frankyhub/Roby_Eyes/README.md

<div align="center">

|[:skull:ISSUE](https://github.com/frankyhub/Roby_Eyes/issues?q=is%3Aissue)|[:speech_balloon: Forum /Discussion](https://github.com/frankyhub/Roby_Eyes/discussions)|[:grey_question:WiKi](https://github.com/frankyhub/Roby_Eyes/wiki)||
|--|--|--|--|
| | | | |
<a href="https://github.com/frankyhub/Roby_Eyes/issues">|<a href="https://github.com/frankyhub/Roby_Eyes/discussions">|<a href="https://github.com/frankyhub/Roby_Eyes/6eleases">||
|| <a href="https://github.com/frankyhub/Roby_Eyes/pulse" alt="Activity">| <a href="https://github.com/frankyhub/Roby_Eyes/graphs/traffic">  |<a href="https://github.com/frankyhub?tab=stars"> ||

# Roby_Eyes

 
<br> <br>

## Story:
Das Repo beschreibt den Roby_Eyes, er hat zwei MAX7219 Displays für die Augen und er kann laufen, tanzen und den Moonwalk. Jedes Bein hat zwei Gelenke, die von Servo-Motoren bewegt werden. Als Steuerung dient ein Arduino NANO, gespeist von einer 9V-Batterie.
Die Roby_Eyes-Elemente werden aus einer 3mm Sperrholzplatte gelasert.

## Die Stückliste:

| Anzahl | Bezeichnung | 
| --- | --- |
| 1  | Sperrholzplatte 300x600x3mm  | 
|  1 | NANO-Shield  | 
| 1  | Arduino NANO V3  | 
| 1  |  40 Pin Male 2,54mm Stiftleisten einreihig für das NANO-Shield | 
|  1 |  40 Pin Female 2,54 mm Buchsenleiste einreihig für das NANO-Shield | 
| 1  | Schalter 1 polig  | 
| 2  | MAX7219 Displays  | 
| 1  | 9V Batterie  | 
| 1  | 9V Batterie-Klipp  | 
| 4  | Servo Motore SG90  | 
| 2  | Zylinderkopf Schrauben M3x8  | 
| 1  | Kabelbinder 10cm  | 
| 1  | Holzleim  | 
| 1  | Sekundenkleber  | 
| 1  | 20cm Schaltlitze 0,25mm2  | 

## Der NANO mit Shield und Stiftleisten

 
<br> <br>

## Aufbau und Montage

Der Aufbau und die Montage von Robi ist in mehrere Schritte unterteilt

## Schritt 1: 

Verwende die Lasercutter Vorlage, bestehend aus, Kopfteil, Füße und Schuhe

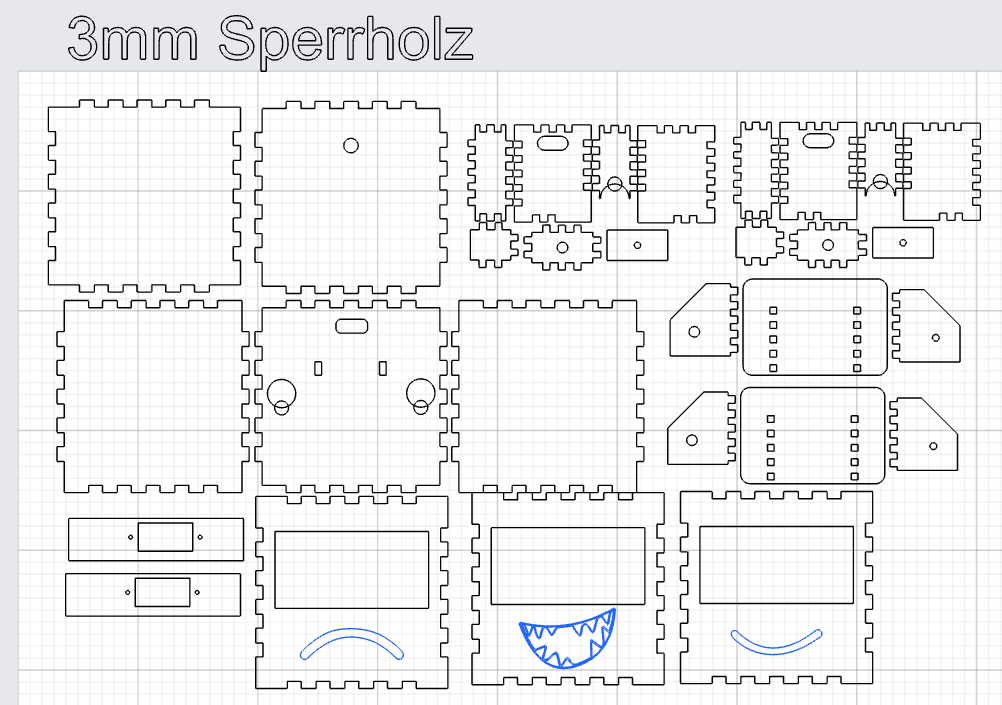
[picture p1: pic/07robi.png]
 
<br> <br>

## Schritt 2: 

Das Kopfteil montieren. Die Deckplatte noch nicht verkleben.

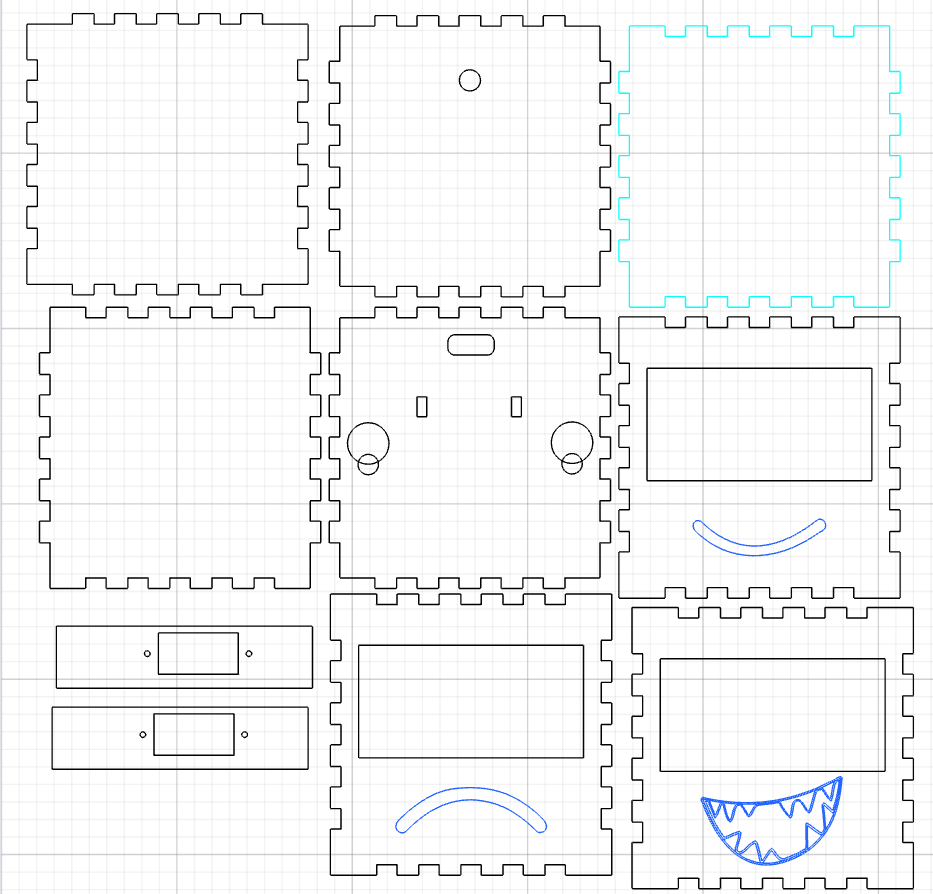
[picture p2: pic/08robi.png]
 
<br> <br>

## Schritt 3: 

Die Hülle der beiden Füße verkleben.
Achtung: Wir benötigen zwei Füße. Die Öffnungen für die Servokabel sind jeweils innen und die Servos zeigen nach vorne!

 
<br> <br>

 
<br> <br>

 
<br> <br>

Die beiden Oberteile der Füße deckungsgleich verkleben (noch nicht an die Füße kleben!).

 
<br> <br>

Die Oberteile der Füße werden an den Servo im Kopfteil geschraubt.

Alternativ können zu besseren Stabilität auch die 3D-Druck Teile verwendet werden.

 
<br> <br>

## Schritt 4: 
Den Robi verdrahten, die Bauteile jedoch noch nicht in das Gehäuse montieren.

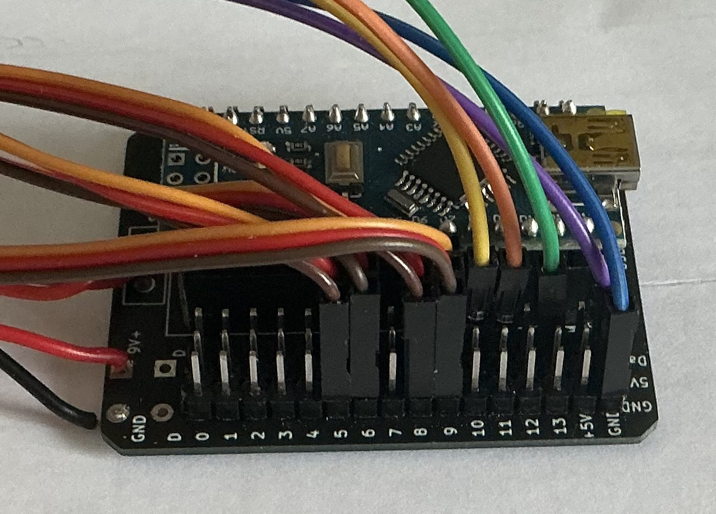
[picture p3: pic/NANO.png]
 
<br> <br>

|	Servo	|	NANO|
| --- | --- |
| Servo rechts oben| D5|
| Servo rechts unten | D6 |
| Servo links oben | D8 |
| Servo links unten  |D9 |
| -------- | -------- | 

 
<br> <br>

<br> <br>

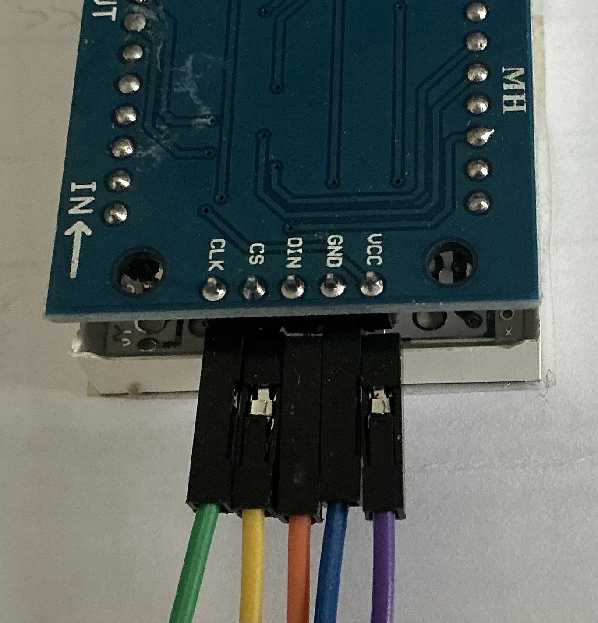
[picture p4: pic/MAX.png]
 
<br> <br>

  |  MAX72xx | NANO |
| -------- | -------- | 
|    VCC | 5V|
|    GND| GND|
 |   DIN | D11|
|    CS |  D10|
|    CLK | D13|
| -------- | -------- | 

## Schritt 5: 
Wir starten den ersten Funktionstest. Den NANO mit der Arduino IDE (Robi_tanzt.ino) programmieren. Es stehen auch Testprogramme für die Servos und das LED-Display zur Verfügung.

Im Robi_tanzt.ino Programm kann zur korrekten Position der Servos der CALIBRATION-Modus gewählt werden (Programmzeile 233).

Ist der Robi programmiert und sind die Servos in 90° Stellung, können sie in das Kopfteil und in die Füße montiert werden.

## Schritt 6: 
Die beiden Servos in 90° Stellung mit den unteren Kopfteil und den Oberteil der Füße verschrauben. Die Servos sollten durch die Verschraubung fest am Kopfteil sitzen. Anschließend die 9V-Batterie mit den Kabelbinder befestigen.

 
<br> <br>

Die Schrittmotore in die Fußhülle montieren und das Fuß Unterteil ankleben

 
<br> <br>

Die Schuhe an die Füße montieren

 
<br> <br>

Die Servo-Kabel in den Body führen und die Füße an die Fußoberteile kleben

 
<br> <br>

Alternativ können zu besseren Stabilität auch die 3D-Druck Teile verwendet werden.

 
<br> <br>

## Schritt 7: 

Das "RUN" Programm in den NANO laden.

Es stehen 3 Programm-Modis zur Verfügung.

In der Programmzeile 233 den "RUN" Modus auswählen:

+ //#define INSTALL
+ //#define CALIBRATION
+ #define RUN

Ist der erste Funktionstest erfolgreich, kleben wir die 3D Druck Abstandshalter auf das NANO-Shield und kleben den NANO 
mit Shield, das LED-Display in das Kopfteil und montieren den Schalter in die Kopfteil Platte. Das Kopfteil jetzt 
vollständig zusammenbauen.

</div>

<div align="center">
  
## Schritt 8

Es stehen auch 3D-Druck Arme zur Verfügung, die an das Kopfteil geklebt werden. 

Jetzt kann Roby tanzen.

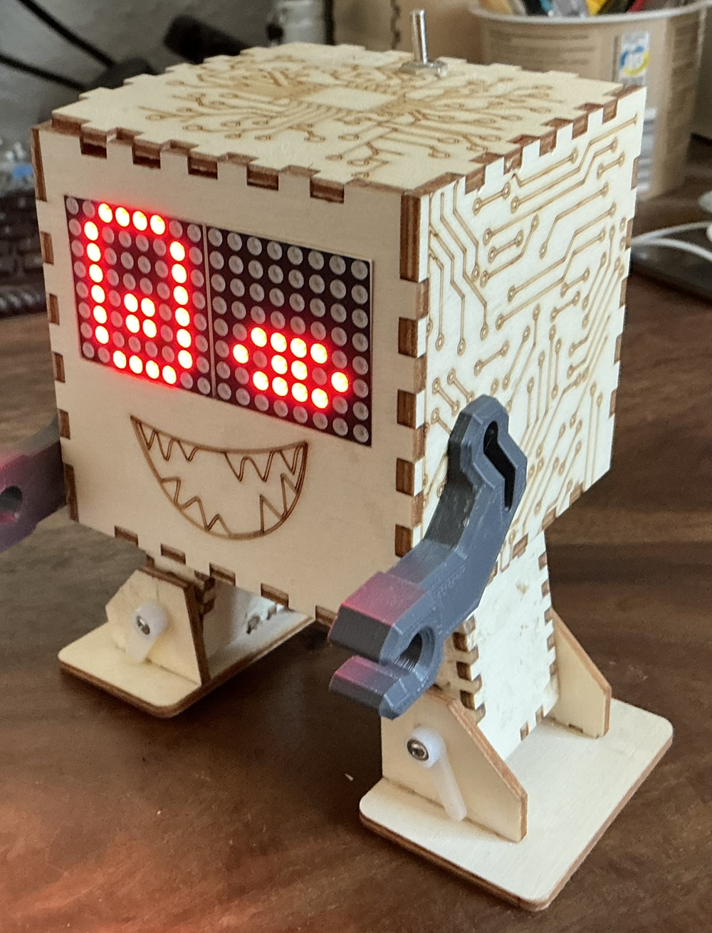
[picture p5: pic/RobiEyes.png]
 
<br> <br>
  
---

## Servo-Motor Impulsdiagramme:

 
<br> <br>

Impulsdiagramm: Ansteuerung des Servos mit einer Frequenz von 50 Hz:

 
<br> <br>

Impulsdiagramm: Ansteuerung des Servos mit einer Impulsbreite von 2,5ms (180°):

 
<br> <br>

---

<div style="position:absolute; left:2cm; ">   
<ol class="breadcrumb" style="border-top: 2px solid black;border-bottom:2px solid black; height: 45px; width: 900px;"> <p align="center"><a href="#oben">nach oben</a></p></ol>
</div>  

---
