frankyhub/Roby_Eyes/code/README.md

NANO V3 Pinout

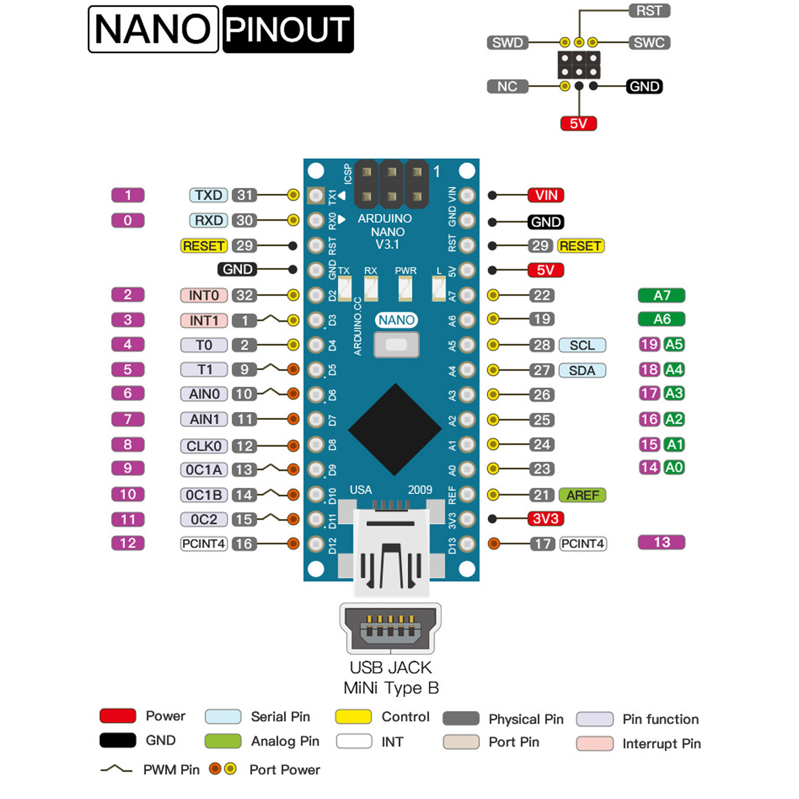
[picture p6: pic/NANOV3.png]
 
<br> <br
