frankyhub/Roby_Eyes/kicad/NANO_Shield/README.md

## NANO Shield

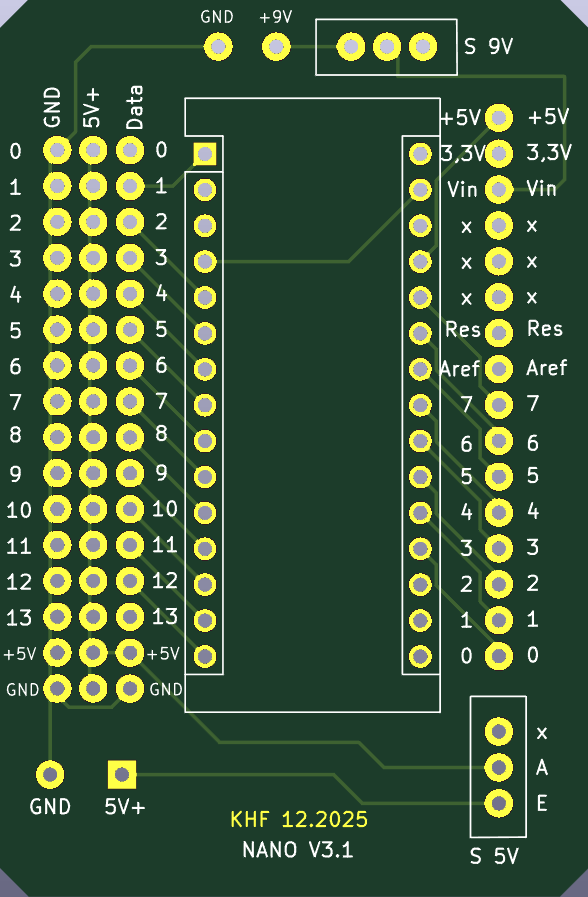
[picture p7: kicad/NANO_Shield/NANO_Shield.png]
 
<br> <br>
