frankyhub/Roby_Eyes/3D/ArmR13.stl

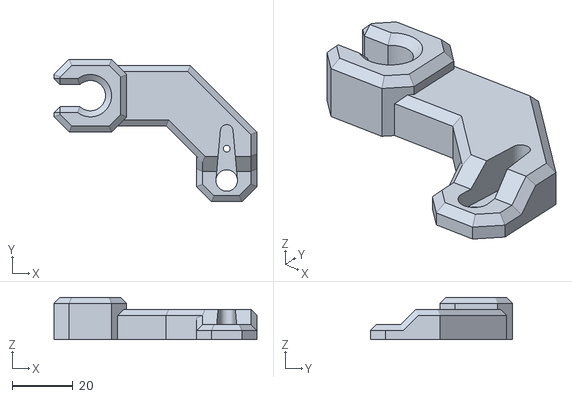
[picture p8: CAD file, 2026-10-29]
3D/ArmR13.stl
67.0 x 47.0 x 14.0
