frankyhub/Roby_Eyes/3D/5mmPins.stl

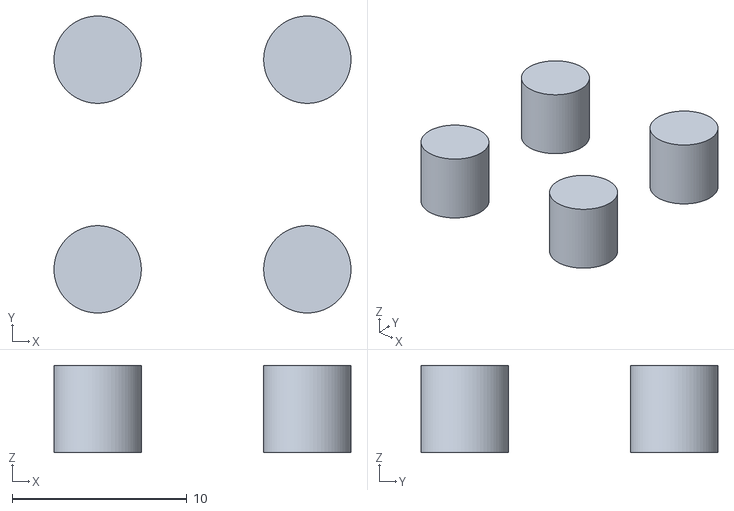
[picture p9: CAD file, 2026-07-21]
3D/5mmPins.stl
17.0 x 17.0 x 5.00
