frankyhub/Roby_Eyes/(list of files, cad)

Other CAD files:
3D/ArmL13.stl
3D/servo_Fuss.scad
3D/servo_Schuh_Li.scad
3D/servo_Schuh_Re.scad
3D/5mmPins.scad
