frankyhub/Roby_Eyes/code/Robi_tanzt/Robi_tanzt.ino

/************************************************************************************************* 
                                      PROGRAMMINFO
************************************************************************************************** 
Funktion: ROBI tanzt - 2 x MAX72xx Display changed eyes

!!!In der Programmzeile 233 den Modus einstellen:
//Programmauswahl - Nur EIN Programm aktivieren!!!
//#define INSTALL
//#define CALIBRATION
#define RUN

**************************************************************************************************
Version: 28.10.2026
**************************************************************************************************
Board: NANO V3 old Bootloader
**************************************************************************************************
C++ Arduino IDE V1.8.13
**************************************************************************************************
Einstellungen:
https://dl.espressif.com/dl/package_esp32_index.json
http://dan.drown.org/stm32duino/package_STM32duino_index.json
https://raw.githubusercontent.com/espressif/arduino-esp32/gh-pages/package_esp32_dev_index.json
************************************************************************************************* 
    RU.attach(5);    // Servo rechts oben an pin 5
    RL.attach(6);   // Servo rechts unten an pin 6 
    LU.attach(8);   // Servo links oben an pin pin 8 
    LL.attach(9);   // Servo links unten an pin 9 

    MAX72xx - NANO
    VCC - 5V
    GND - GND
    DIN - D11
    CS -  D10
    CLK - D13

**************************************************************************************************/

#include "LedControl.h" //V1.0.6
LedControl lc=LedControl(11,13,10,2); //DIN, CLK, CS, Anzahl der Module

#include "VarSpeedServo.h"  
#include <NewPing.h>        

VarSpeedServo RU;  //rechts oben
VarSpeedServo RL;  //rechts unten
VarSpeedServo LU;  //links oben
VarSpeedServo LL;  //links unten

NewPing sonar(4,3,200); 
                                                     //vel(min), delay_Forward(max) = (5, 2000) 
const int vel = 40, vel_Back = 15;                   //vel(mid), delay_Forward(mid) = (20, 750) 
const int delay_Forward = 300, delay_Back = 750;     //vel(max), delay_Forward(min)= (256, 50)
                                                     //Empfelung ---> (10, 700) (50, 500) (100, 100) (100, 300) (100, 500)

int vel_Dance1 = 30,    vel_Dance2 = 25,    vel_Dance3 = 40;     
int delay_Dance1 = 300, delay_Dance2 = 750, delay_Dance3 = 200;  

int vel_Dance4 = 40,    vel_Dance5 = 40,    vel_Dance6 = 30;
int delay_Dance4 = 400, delay_Dance5 = 400, delay_Dance6 = 500;

const int array_cal[4] = {90,90,90,90};    
int RU_Degree = 0, LU_Degree = array_cal[2] + 5;

const int num_dance1 = 10;
const int array_dance1[num_dance1][4] =
{ 
//slide links 0-4
    {0,-20,0,0},  
    {0,-40,0,20},
    {0,-20,0,40},
    {0,0,0,20},
    {0,0,0,0},
    
//slide rechts 5-9
    {0,0,0,20},  
    {0,-20,0,40},
    {0,-40,0,20},
    {0,-20,0,0},
    {0,0,0,0}, 
};

const int num_dance2 = 32;
const int array_dance2[num_dance2][4] =
{ 
//linker Fuß 0-15
    {20,0,40,0},
    {20,-30,40,-30}, 
    {20,-30,10,-30},
    {20,-30,40,-30}, 
    {20,-30,10,-30},

    {20,-30,40,-30}, 
    {20,0,40,-30},
    {20,80,40,-30},
    {20,0,40,-30},
    {20,-80,40,-30},        
    {20,0,40,-30},
    {20,80,40,-30},
    {20,0,40,-30},
    {20,-30,40,-30},    
    {20,0,40,0},
    {0,0,0,0}, 
     
//rechter Fuß 16-31
    {-40,0,-20,0},
    {-40,40,-20,30}, 
    {-20,40,-20,30}, 
    {-40,40,-20,30}, 
    {-20,40,-20,30}, 

    {-40,40,-20,30}, 
    {-40,40,-20,0},
    {-40,40,-20,-80},
    {-40,40,-20,0},
    {-40,40,-20,80},        
    {-40,40,-20,0},
    {-40,40,-20,-80},
    {-40,40,-20,0},
    {-40,40,-20,30},    
    {-40,0,-20,0},
    {0,0,0,0},
};

const int num_dance3 = 8;        //split step
const int array_dance3[num_dance3][4] =
{ 
    {0,-40,0,0},
    {20,-30,20,20},
    {40,0,40,30},   
    {0,0,0,40},
    {-20,-20,-20,30},
    {-40,-30,-40,0},

    {0,-40,0,0},
    {0,0,0,0},
};

const int num_dance4 = 20;      //nach innen und beschleunigen
const int array_dance4[num_dance4][4] =
{     
    {0,-20,0,20},   
    {0,0,0,0},
    {0,-20,0,20},
    {0,0,0,0},
    {0,-20,0,20},
    {0,0,0,0},
    {0,-20,0,20},
    {0,0,0,0},
    
    {0,-50,0,50},
    {0,0,0,0},    
    {0,-50,0,50},
    {0,0,0,0},    
    {0,-50,0,50},
    {0,0,0,0},    
    {0,-50,0,50},
    {0,0,0,0},
    
    {0,-40,0,40},
    {0,-50,0,50},
    {0,-60,0,60},
    {0,0,0,0,},
};

const int num_dance5 = 17;
const int array_dance5[num_dance5][4] =
{ 
    {35,0,15,0},    //beide Beine berühren lassen
    {35,30,15,30},   
    {-35,30,15,30},   
    {-20,0,15,0},
    {0,0,0,0},

    {0,-40,0,40},    //nach innen und drehen Beine
    {-30,-40,-20,40},
    {0,-40,0,40},
    {20,-40,30,40},    

    
    {0,-40,0,40},    //An Ort und Stelle auf und ab gehen und Beine drehen
    {20,-40,-20,40},   
    {20,-20,-20,20},
    {20,0,-20,0},   
    {-20,-10,20,10},
    {-10,-30,10,30},

    {0,-40,0,40},
    {0,0,0,0},
};

const int num_dance6 = 32;      
const int array_dance6[num_dance6][4] =
{   
    {0,-40,0,-20},        //weitergehen
    {25,-40,18,-20},
    {25,0,18,0},
    {0,20,0,40},
    {-18,20,-25,40},
    {-18,0,-25,0},
      
    {0,-40,0,-20},        //rausziehen
    {25,-40,18,-20},
    {0,0,0,0},
    {0,20,0,40},
    {-18,20,-25,40},
    {0,0,0,0},

    {0,-40,0,-20},        //rausziehen - zurück
    {-25,-40,-18,-20},
    {-25,0,-18,0},
    {0,20,0,40},
    {18,20,25,40},
    {18,0,25,0},

    {0,-40,0,-20},        //vorwärts
    {30,-40,30,-20},
    {30,0,30,0},
    {0,20,0,40},
    {-30,20,-30,40},
    {-30,0,-30,0},
  
    {0,-40,0,-20},        //zurück
    {-30,-40,-30,-20},
    {-30,0,-30,0},
    {0,20,0,40},
    {30,20,30,40},
    {30,0,30,0},

    {15,0,15,0},
    {0,0,0,0},
};

//Programmauswahl - Nur EIN Programm aktivieren!!!
//#define INSTALL
//#define CALIBRATION
#define RUN

void Servo_Init()
{
    RU.attach(5);    // Servo rechts oben an pin 5
    RL.attach(6);   // Servo rechts unten an pin 6 
    LU.attach(8);   // Servo links oben an pin pin 8 
    LL.attach(9);   // Servo links unten an pin 9 
}

void Adjust()                            // Vermeide das schnelle Spinnen des Servos bei der Initialisierung
{                                        // RU,LU geht von array_cal[0] - 5 ,array_cal[2] + 5 Grad auf array_cal[0],array_cal[2] Grad
    for(RU_Degree = array_cal[0] - 5; RU_Degree <= array_cal[0]; RU_Degree += 1) {
        RU.write(RU_Degree);             // in Schritten von 1 Grad
        LU.write(LU_Degree--);           // sage den Servo, dass er zu RU_Degreeition gehen soll, LU_Degreeition in der Variable "RU_Degree", "LU_Degree"       
        delay(15);                       // wartet 15ms, bis der Servo die RU_Degreeition erreicht hat
    }
}

bool TooClose()
{
    int tooclose = 0;
    for(int a=0; a<5; a++) {  
        delay(50);
        int din = sonar.ping_in();
        if (din < 7 && din > 0) tooclose++;
    }
    if (tooclose < 5) return 1;   
    return 0;
}

void Slide_2_Left(int times)
{
    for(int time1 = 0; time1 < times; time1++) { 
        for(int z=0; z<5; z++) {                     
            RU.slowmove (array_cal[0] + array_dance1[z][0] , vel_Dance1);   
            RL.slowmove (array_cal[1] + array_dance1[z][1] , vel_Dance1);
            LU.slowmove (array_cal[2] + array_dance1[z][2] , vel_Dance1);
            LL.slowmove (array_cal[3] + array_dance1[z][3] , vel_Dance1);
            delay(delay_Dance1); 
        } 
    }
}

void Slide_2_Right(int times)
{
    for(int time1 = 0; time1 < times; time1++) {
        for(int z=5; z<10; z++) {                     
            RU.slowmove (array_cal[0] + array_dance1[z][0] , vel_Dance1);   
            RL.slowmove (array_cal[1] + array_dance1[z][1] , vel_Dance1);
            LU.slowmove (array_cal[2] + array_dance1[z][2] , vel_Dance1);
            LL.slowmove (array_cal[3] + array_dance1[z][3] , vel_Dance1);
            delay(delay_Dance1); 
        }   
    }
}

void Left_Foot_Support()
{
    for(int z=0; z<16; z++) { //z<12
        if ( z > 5 && z < 14) {   //z(1,10)
            vel_Dance2 = 50;
            delay_Dance2 = 200;
        }
        else { 
        vel_Dance2 = 25; 
        delay_Dance2 = 750;
        }
                    
        RU.slowmove (array_cal[0] + array_dance2[z][0] , vel_Dance2);   
        RL.slowmove (array_cal[1] + array_dance2[z][1] , vel_Dance2);
        LU.slowmove (array_cal[2] + array_dance2[z][2] , vel_Dance2);
        LL.slowmove (array_cal[3] + array_dance2[z][3] , vel_Dance2);
        delay(delay_Dance2); 
    }
}

void Right_Foot_Support()
{
    for(int z=16; z<32; z++) { //z<24
        if ( z > 21 && z < 30) {   //z(13,22)
            vel_Dance2 = 50;
            delay_Dance2 = 200;
        }
        else { 
        vel_Dance2 = 25; 
        delay_Dance2 = 750;
        }
                    
        RU.slowmove (array_cal[0] + array_dance2[z][0] , vel_Dance2);   
        RL.slowmove (array_cal[1] + array_dance2[z][1] , vel_Dance2);
        LU.slowmove (array_cal[2] + array_dance2[z][2] , vel_Dance2);
        LL.slowmove (array_cal[3] + array_dance2[z][3] , vel_Dance2);
        delay(delay_Dance2); 
    }
}

void Dancing1_2()
{
    Slide_2_Left(2);
    Left_Foot_Support();
    
    Slide_2_Right(2);
    Right_Foot_Support();
}

void Dancing3(int Times = 1, int Vel = 40, int Delay = 250, int low = 0, int high = 0)
{   
    for(int time3 = 0; time3 < Times; time3++) {
        for(int z=0; z<6; z++) {
            if ( time3 > 1 && time3 < 4) {
            vel_Dance3 = Vel;
            delay_Dance3 = Delay;
            }
            else { 
            vel_Dance3 = 40; 
            delay_Dance3 = 200;
            }                     
            
            RU.slowmove (array_cal[0] + array_dance3[z][0] , vel_Dance3);   
            RL.slowmove (array_cal[1] + array_dance3[z][1] , vel_Dance3);
            LU.slowmove (array_cal[2] + array_dance3[z][2] , vel_Dance3);
            LL.slowmove (array_cal[3] + array_dance3[z][3] , vel_Dance3);
            delay(delay_Dance3); 
        } 
    }
    for(int z=6; z<8; z++) {                     
            RU.slowmove (array_cal[0] + array_dance3[z][0] , vel_Dance3);   
            RL.slowmove (array_cal[1] + array_dance3[z][1] , vel_Dance3);
            LU.slowmove (array_cal[2] + array_dance3[z][2] , vel_Dance3);
            LL.slowmove (array_cal[3] + array_dance3[z][3] , vel_Dance3);
            delay(delay_Dance3); 
        }       
}

void Dancing4()
{  
    for(int z=0; z<num_dance4; z++) {
        if ( z > 17) {
            vel_Dance4 = 10;
            delay_Dance4 = 1500;
            }
        else {
            vel_Dance4 = 40;
            delay_Dance4 = 400;
            }
                 
        RU.slowmove (array_cal[0] + array_dance4[z][0] , vel_Dance4);   
        RL.slowmove (array_cal[1] + array_dance4[z][1] , vel_Dance4);
        LU.slowmove (array_cal[2] + array_dance4[z][2] , vel_Dance4);
        LL.slowmove (array_cal[3] + array_dance4[z][3] , vel_Dance4);
        delay(delay_Dance4); 
    } 
}

void Dancing5()
{   
    for(int x = 0; x < 3; x++) {
        for(int z=0; z<5; z++) {                     
            RU.slowmove (array_cal[0] + array_dance5[z][0] , vel_Dance5);   
            RL.slowmove (array_cal[1] + array_dance5[z][1] , vel_Dance5);
            LU.slowmove (array_cal[2] + array_dance5[z][2] , vel_Dance5);
            LL.slowmove (array_cal[3] + array_dance5[z][3] , vel_Dance5);
            delay(delay_Dance5); 
        } 
    }
   
    for(int x = 0; x < 2; x++) {
        for(int z=5; z<9; z++) {                     
            RU.slowmove (array_cal[0] + array_dance5[z][0] , 30);   
            RL.slowmove (array_cal[1] + array_dance5[z][1] , 30);
            LU.slowmove (array_cal[2] + array_dance5[z][2] , 30);
            LL.slowmove (array_cal[3] + array_dance5[z][3] , 30);
            delay(550); 
        } 
    }
    
    for(int x = 0; x < 3; x++) {
        for(int z=9; z<15; z++) {                     
            RU.slowmove (array_cal[0] + array_dance5[z][0] , vel_Dance5);   
            RL.slowmove (array_cal[1] + array_dance5[z][1] , vel_Dance5);
            LU.slowmove (array_cal[2] + array_dance5[z][2] , vel_Dance5);
            LL.slowmove (array_cal[3] + array_dance5[z][3] , vel_Dance5);
            delay(300); 
        } 
    }    
    for(int z=15; z<17; z++) {                     
            RU.slowmove (array_cal[0] + array_dance5[z][0] , 10);   
            RL.slowmove (array_cal[1] + array_dance5[z][1] , 10);
            LU.slowmove (array_cal[2] + array_dance5[z][2] , 10);
            LL.slowmove (array_cal[3] + array_dance5[z][3] , 10);
            delay(1500); 
        }   
}

void Dancing6()
{   
    const int array_cal_0 = array_cal[0] + 10 , array_cal_2 = array_cal[2] - 10;
    
    for(int x = 0; x < 3; x++) {
        for(int z=0; z<6; z++) {                     
            RU.slowmove (array_cal_0 + array_dance6[z][0] , vel_Dance6);   
            RL.slowmove (array_cal[1] + array_dance6[z][1] , vel_Dance6);
            LU.slowmove (array_cal_2 + array_dance6[z][2] , vel_Dance6);
            LL.slowmove (array_cal[3] + array_dance6[z][3] , vel_Dance6);
            delay(delay_Dance6); 
        } 
    }
   
    for(int x = 0; x < 3; x++) {
        for(int z=6; z<12; z++) {                     
            RU.slowmove (array_cal_0 + array_dance6[z][0] , 40);   
            RL.slowmove (array_cal[1] + array_dance6[z][1] , 40);
            LU.slowmove (array_cal_2 + array_dance6[z][2] , 40);
            LL.slowmove (array_cal[3] + array_dance6[z][3] , 40);
            delay(400); 
        } 
    }
    
    for(int x = 0; x < 3; x++) {
        for(int z=12; z<18; z++) {                     
            RU.slowmove (array_cal_0 + array_dance6[z][0] , vel_Dance6);   
            RL.slowmove (array_cal[1] + array_dance6[z][1] , vel_Dance6);
            LU.slowmove (array_cal_2 + array_dance6[z][2] , vel_Dance6);
            LL.slowmove (array_cal[3] + array_dance6[z][3] , vel_Dance6);
            delay(delay_Dance6); 
        } 
    }  
    for(int x = 0; x < 3; x++) {
        for(int z=18; z<24; z++) {                     
            RU.slowmove (array_cal[0] + array_dance6[z][0] , vel_Dance6);   
            RL.slowmove (array_cal[1] + array_dance6[z][1] , vel_Dance6);
            LU.slowmove (array_cal[2] + array_dance6[z][2] , vel_Dance6);
            LL.slowmove (array_cal[3] + array_dance6[z][3] , vel_Dance6);
            delay(delay_Dance6); 
        } 
    }

    for(int x = 0; x < 3; x++) {
        for(int z=24; z<30; z++) {                     
            RU.slowmove (array_cal[0] + array_dance6[z][0] , vel_Dance6);   
            RL.slowmove (array_cal[1] + array_dance6[z][1] , vel_Dance6);
            LU.slowmove (array_cal[2] + array_dance6[z][2] , vel_Dance6);
            LL.slowmove (array_cal[3] + array_dance6[z][3] , vel_Dance6);
            delay(delay_Dance6); 
        } 
    }
    for(int z=30; z<32; z++) {                     
            RU.slowmove (array_cal[0] + array_dance5[z][0] , 10);   
            RL.slowmove (array_cal[1] + array_dance5[z][1] , 10);
            LU.slowmove (array_cal[2] + array_dance5[z][2] , 10);
            LL.slowmove (array_cal[3] + array_dance5[z][3] , 10);
            delay(1500); 
        }     
}

void eyes(){
  lc.setRow(0,0,B00000000);
  lc.setRow(0,1,B00111100);
  lc.setRow(0,2,B01000010);
  lc.setRow(0,3,B01011010);
  lc.setRow(0,4,B01011010);
  lc.setRow(0,5,B01000010);
  lc.setRow(0,6,B00111100);
  lc.setRow(0,7,B00000000);

  lc.setRow(1,0,B00000000);
  lc.setRow(1,1,B00111100);
  lc.setRow(1,2,B01000010);
  lc.setRow(1,3,B01011010);
  lc.setRow(1,4,B01011010);
  lc.setRow(1,5,B01000010);
  lc.setRow(1,6,B00111100);
  lc.setRow(1,7,B00000000);
}

void eyeswink(){
  lc.setRow(0,0,B00000000);
  lc.setRow(0,1,B00000000);
  lc.setRow(0,2,B00000000);
  lc.setRow(0,3,B00000000);
  lc.setRow(0,4,B00111100);
  lc.setRow(0,5,B01011010);
  lc.setRow(0,6,B00111100);
  lc.setRow(0,7,B00000000);

  lc.setRow(1,0,B00111100);
  lc.setRow(1,1,B01000010);
  lc.setRow(1,2,B01000010);
  lc.setRow(1,3,B01000010);
  lc.setRow(1,4,B01011010);
  lc.setRow(1,5,B01011010);
  lc.setRow(1,6,B01000010);
  lc.setRow(1,7,B00111100);
}

void eyesclose(){
  // 2 x Eyes close
  lc.setRow(0,0,B00000000);
  lc.setRow(0,1,B00000000);
  lc.setRow(0,2,B00000000);
  lc.setRow(0,3,B00000000);
  lc.setRow(0,4,B00111100);
  lc.setRow(0,5,B01000010);
  lc.setRow(0,6,B01011010);
  lc.setRow(0,7,B00111100);

  lc.setRow(1,0,B00000000);
  lc.setRow(1,1,B00000000);
  lc.setRow(1,2,B00000000);
  lc.setRow(1,3,B00000000);
  lc.setRow(1,4,B00111100);
  lc.setRow(1,5,B01000010);
  lc.setRow(1,6,B01011010);
  lc.setRow(1,7,B00111100);
}

void eyesclose2(){
  // 2 x Eyes up
  lc.setRow(0,0,B00000000);
  lc.setRow(0,1,B00000000);
  lc.setRow(0,2,B00000000);
  lc.setRow(0,3,B00000000);
  lc.setRow(0,4,B00111100);
  lc.setRow(0,5,B01000010);
  lc.setRow(0,6,B01011010);
  lc.setRow(0,7,B00111100);

  lc.setRow(1,0,B00000000);
  lc.setRow(1,1,B00000000);
  lc.setRow(1,2,B00000000);
  lc.setRow(1,3,B00000000);
  lc.setRow(1,4,B00111100);
  lc.setRow(1,5,B01000010);
  lc.setRow(1,6,B01011010);
  lc.setRow(1,7,B00111100);
}



void eyesdown(){
  // 2 x Eyes down
  lc.setRow(0,0,B00111100);
  lc.setRow(0,1,B01000010);
  lc.setRow(0,2,B01000010);
  lc.setRow(0,3,B01000010);
  lc.setRow(0,4,B01000010);
  lc.setRow(0,5,B01011010);
  lc.setRow(0,6,B01011010);
  lc.setRow(0,7,B00111100);

  lc.setRow(1,0,B00111100);
  lc.setRow(1,1,B01000010);
  lc.setRow(1,2,B01000010);
  lc.setRow(1,3,B01000010);
  lc.setRow(1,4,B01000010);
  lc.setRow(1,5,B01011010);
  lc.setRow(1,6,B01011010);
  lc.setRow(1,7,B00111100);
}

void eyesleft(){
  // 2 x Eyes left
  lc.setRow(0,0,B00000000);
  lc.setRow(0,1,B00000000);
  lc.setRow(0,2,B00111100);
  lc.setRow(0,3,B01000010);
  lc.setRow(0,4,B01110010);
  lc.setRow(0,5,B01110010);
  lc.setRow(0,6,B01000010);
  lc.setRow(0,7,B00111100);

  lc.setRow(1,0,B00000000);
  lc.setRow(1,1,B00000000);
  lc.setRow(1,2,B00111100);
  lc.setRow(1,3,B01000010);
  lc.setRow(1,4,B01110010);
  lc.setRow(1,5,B01110010);
  lc.setRow(1,6,B01000010);
  lc.setRow(1,7,B00111100);
}

    void eyesright(){
  // 2 x Eyes right
  lc.setRow(0,0,B00000000);
  lc.setRow(0,1,B00000000);
  lc.setRow(0,2,B00111100);
  lc.setRow(0,3,B01000010);
  lc.setRow(0,4,B01001110);
  lc.setRow(0,5,B01001110);
  lc.setRow(0,6,B01000010);
  lc.setRow(0,7,B00111100);

  lc.setRow(1,0,B00000000);
  lc.setRow(1,1,B00000000);
  lc.setRow(1,2,B00111100);
  lc.setRow(1,3,B01000010);
  lc.setRow(1,4,B01001110);
  lc.setRow(1,5,B01001110);
  lc.setRow(1,6,B01000010);
  lc.setRow(1,7,B00111100);
}

    void eyesangry(){
   //2 x Eyes angry
  lc.setRow(0,0,B00000010);
  lc.setRow(0,1,B00000110);
  lc.setRow(0,2,B00001010);
  lc.setRow(0,3,B00010010);
  lc.setRow(0,4,B00101010);
  lc.setRow(0,5,B01011010);
  lc.setRow(0,6,B01000010);
  lc.setRow(0,7,B00111100);
   
  lc.setRow(1,0,B01000000);
  lc.setRow(1,1,B01100000);
  lc.setRow(1,2,B01010000);
  lc.setRow(1,3,B01001000);
  lc.setRow(1,4,B01010100);
  lc.setRow(1,5,B01011010);
  lc.setRow(1,6,B01000010);
  lc.setRow(1,7,B00111100);
}





void setup()  
{
Serial.begin(11500);

Serial.print("lets go");  

  for(int i=0;i<2;i++){
    lc.shutdown(i,false);
    lc.setIntensity(i,8);
    lc.clearDisplay(i);
  }

  
#ifdef INSTALL
    Servo_Init();
  
    RU.slowmove (90 , vel);
    RL.slowmove (90 , vel);
    LU.slowmove (90 , vel);
    LL.slowmove (90 , vel);
    while(1);
#endif

#ifdef CALIBRATION 
    Servo_Init();  
    Adjust();
    
    RL.slowmove (array_cal[1] , vel);
    LL.slowmove (array_cal[3] , vel);
    delay(2000);
    while(1);
#endif

#ifdef RUN 
    Servo_Init();
    Adjust(); 
       
    RL.slowmove (array_cal[1] , vel);
    LL.slowmove (array_cal[3] , vel);
    delay(2000);
#endif
}

void loop() 
{  
   eyesright();
   delay(1500); 
   eyesleft();
   delay(1500);  
   eyeswink();
   delay(1500);
   eyes();
   delay(1000);


   
    Dancing1_2();
    eyesclose2();
    delay(500); 

       
    Dancing3(5,20,400);
    eyesdown();
    delay(500); 

       
    Dancing4();
    eyesleft();
    delay(500);
        
    Dancing5();
    eyesright();
    delay(500);   
     
    Dancing6();
    eyesclose();
    delay(3000); 

    eyesangry();
    while(1);
     
}
