frankyhub/Roby_Eyes/(commit log)

2026-10-29 V29102026
    Added detailed assembly instructions and images for Robi.
2026-10-29 V29102026
    Removed images and sections related to component pictures and assembly instructions.
2026-10-29 V29102026
    Updated instructions for assembling the head component.
2026-10-29 V29102026
    Added details about the laser cutter template and included an image.
2026-10-29 V29102026
    Updated instructions for using the laser cutter template.
2026-10-29 V29102026
    Comment out INSTALL and CALIBRATION modes in README.
2026-10-29 V29102026
    Added technical notes for servo motor connections.
2026-10-29 V29102026
    Updated instructions for mounting the NANO and wiring components. Added a table for servo and MAX72xx connections.
2026-10-29 V29102026
    Updated wiring instructions and formatting in README.
2026-10-29 V29102026
    Updated instructions for wiring and programming Robi, including new tables for connections and clarifications on programming modes.
2026-10-29 V29102026
    Updated instructions for step 7 to include additional details about mounting components.
2026-10-29 V29102026
    Added information about 3D-printed arms and function test.
2026-10-29 V29102026
    Added note to not glue the top plate yet.
2026-10-30 V30102026
    Removed duplicate servo connection table and adjusted formatting.
2026-10-30 V30102026
    Removed technical notes and servo motor connection details.
2026-10-30 V30102026
    Clarified instructions for loading the RUN program and assembling components.
